jstjst/stmbl/hw/kicad/v5.0/stmbl_5.0.kicad_pcb

## KiCad design hw/kicad/v5.0/stmbl_5.0.kicad_pcb (2025-01-07)

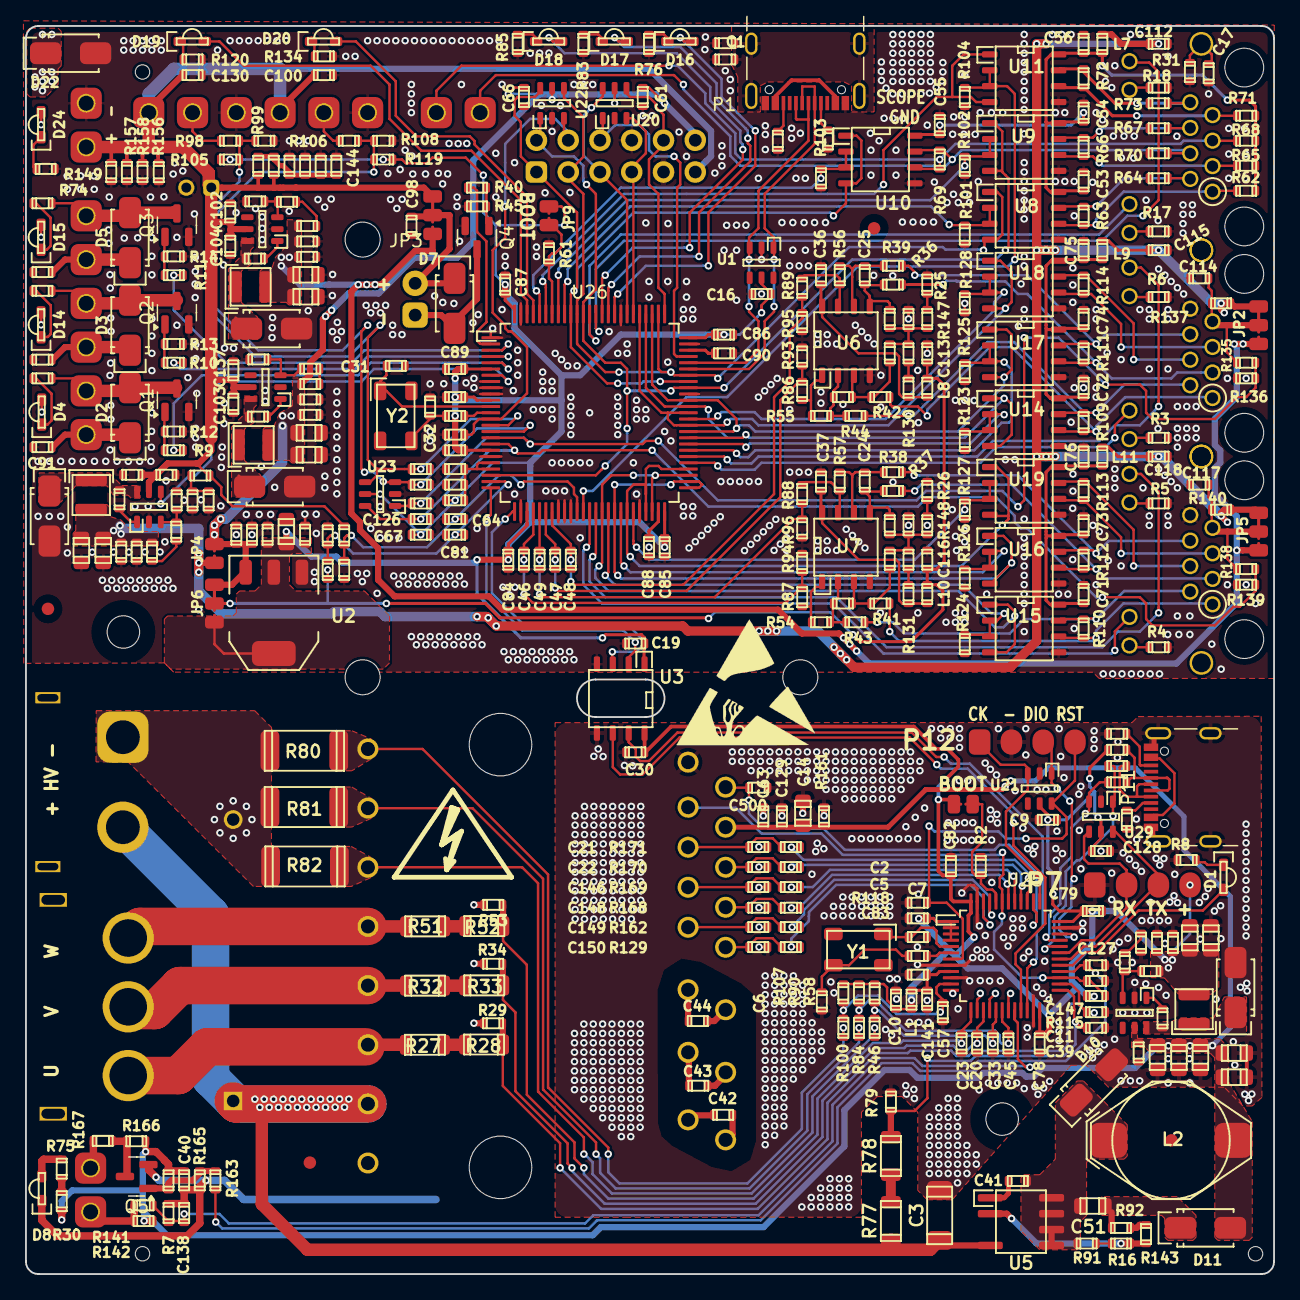
[picture p1: board stmbl_5.0.kicad_pcb from above]

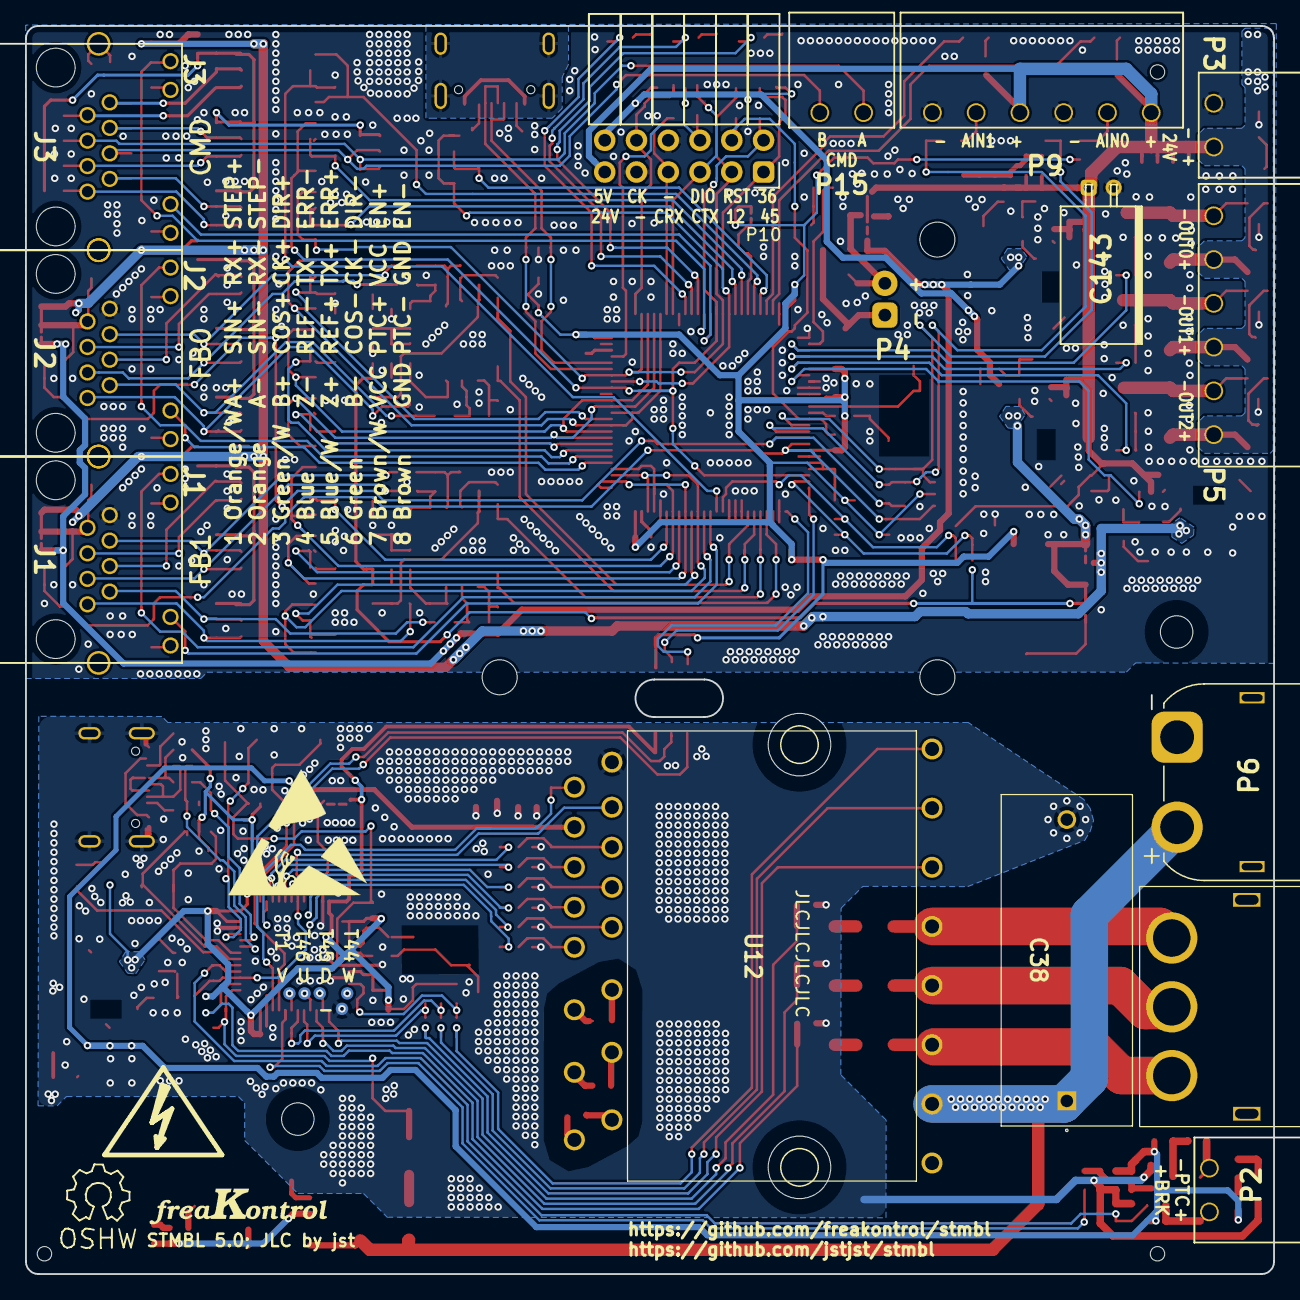
[picture p2: board stmbl_5.0.kicad_pcb from below]

Board: 2 copper layers, 99.8 x 99.8 mm, 425 parts (23 on the bottom side), 243 nets.

Parts:
C1, C2, C7, C9, C10, C12, C13, C15, C16, C17, C19, C29, C30, C36, C37, C40, C41, C53, C54, C55, C56, C58, C60, C61, C63, C66, C67, C71, C72, C73, C74, C75, C76, C77, C78, C79, C80, C82, C83, C84, C85, C86, C87, C89, C91, C94, C95, C96, C98, C99, C100, C103, C104, C105, C106, C107, C108, C112, C113, C114, C115, C116, C117, C118, C119, C120, C121, C122, C125, C126, C127, C128, C130, C138: 100n; C_0603
C3: 150n; C_1808
C4, C14, C35, C51, C68, C69, C70, C97, C109, C110, C111, C123, C124, C131, C132, C145: 10µ; C_0805
C5, C6, C11, C20, C23, C24, C25, C26, C27, C31, C32, C33, C39, C45, C57: 18p; C_0603
C8, C18, C42, C43, C44, C50, C62, C65, C88, C90, C101, C102, C129, C133, C134, C135, C136, C137, C139, C140, C141, C142, C144: 2.2µ; C_0603
C21, C22, C46, C47, C48, C49, C52, C59, C64, C81, C146, C147, C148, C149, C150, C500: 1n; C_0603
C38: 680n; potential_snubber01
C143: 22µ; C_Radial_D6.5_L11_P2.5
D1, D16: red; LED-0805-SIDE
D2, D3, D5, D7, D10, D11: ES1J R2; SMA_Standard
D4, D8, D14, D15, D18, D19, D20, D24: green; LED-0805-SIDE
D6, D9, D12, D13: SS34A; SMA_Standard
D17: yellow; LED-0805-SIDE
D22: SMAJ24A TVS 24V; SMA_Standard
J1, J2, J3: RJ45_LED
JP1, JP4, JP9: Jumper_NO_Small; SOLDER_JUMPER
JP2, JP3, JP5, JP6: JUMPER3_NC; SOLDER_JUMPER_3_NC
L1, L3, L7, L8, L9, L10, L11: 220r 700mA; R_0603
L2: 1m 250mA; NPI31W
L4: 4.7µH; SMD_INDUCTOR_32x25
L5, L12: 6.8µH; SMD_INDUCTOR_32x25
L6: 10µH 1A; SMD_INDUCTOR_32x25
LOGO1: OPEN_HARDWARE_1; Symbol_OSHW-Logo_SilkScreen
LOGO2: LOGO; Logo_Freakontrol_1
P1, P11: USB_C_Receptacle_USB2.0; USB_C_Receptacle_GCT_USB4105-xx-A_16P_TopMnt_Horizontal
P2, P3, P15: CONN_01X02; RM3.5_1x2
P4: CONN_01X02; Pin_Header_Angled_1x02
P5, P9: CONN_01X06; RM3.5_1x6
P6: CONN_01X02; AMASS_XT60IPW-M_1x03_P7.20mm_Horizontal
P7, P12: CONN_01X04; Pin_Header_Straight_1x04_smd
P8: CONN_01X03; AMASS Connector MT60_1
P10: CONN_02X06; Socket_Strip_Angled_2x06
Q1, Q2, Q3, Q4, Q5: IRLML6344; SOT-23
R1, R23, R24, R25, R26, R31, R109, R110, R111, R112, R113, R114, R130, R131: 120; R_0603
R2, R12, R13, R14, R15, R16, R30, R45, R61, R63, R66, R69, R72, R75, R91, R99, R101, R102, R103, R104, R105, R108, R117, R118, R119, R121, R122, R123, R124, R125, R126, R127, R128, R136, R139, R153, R165: 1k; R_0603
R3, R4, R5, R6, R8, R17, R18, R46, R76, R83, R84, R85, R93, R94, R95, R96, R100, R120, R134: 470; R_0603
R7, R35, R36, R37, R38, R39, R41, R42, R43, R44, R62, R64, R65, R67, R68, R70, R71, R73, R98, R106, R116, R132, R135, R137, R138, R140, R142, R155, R156, R157, R158: 10k; R_0603
R9, R10, R11, R40, R86, R87, R88, R89, R147, R148, R154, R159, R160, R163, R167, R175, R176: 22; R_0603
R19, R47, R48, R49, R50, R54, R55, R56, R57, R58, R90, R92, R107: 15k; R_0603
R20, R22, R29, R34, R53, R59, R74, R79, R115, R149, R161, R164, R166: 3.9k; R_0603
R21, R60, R97, R133, R141: 51k; R_0603
R27, R28, R32, R33, R51, R52, R77, R78: 249k; R_1206
R80, R81, R82: 0.002; R_2512
R129, R162, R168, R169, R170, R171: 100; R_0603
R143, R145, R174: 1.5k; R_0603
R144, R146, R152, R172, R173, R177: 5.1k; R_0603
REF1, REF3, REF4: Fiducial_1mm_Dia_2.54mm_Outer_CopperTop; Fiducial_1mm_Outer_CopperTop
T1, T2, T44, T45, T46: testpoint; Measurement_Point_Round-SMD-Pad_Small
U1, U20, U21, U22, U23, U29: USBLC6-4SC6; SOT-23-6
U2: zldo1117; SOT-223
U3: SI8621; SOIC-8-N
U4, U13, U24, U28: RT8259; SOT-23-6
U5: LNK304D; SOIC-7
U6, U7: LM358; SOIC-8-N
U8, U9, U10, U11, U14, U15, U16, U17, U18, U19: SN65176B; SOIC-8-N
U12: IKCM30F60GAXKMA1; IKCM30F60GAXKMA1_2
U25: STM32F303CBTx; LQFP-48_7x7mm_Pitch0.5mm
U26: STM32F405VG; LQFP-100_14x14mm_Pitch0.5mm
U234: fan; radial fan
Y1, Y2: 8M; Crystal_SMD_0503_4Pads

Connections:
+3.3VP: C2.1, C4.1, C9.1, C10.2, C30.2, C35.1, C50.1, C60.1, C78.2, C79.2, C82.2, C128.1, JP1.1, L1.2, L4.2, P7.4, R21.1, R58.2, R90.2, R107.2, R115.1, R174.2, U3.8 (VDD2), U21.5 (VBUS), U25.1 (VBAT), U25.2 (PC13), U25.3 (PC14), U25.4 (PC15), U25.24 (VDD), U25.36 (VDD), U25.48 (VDD), U29.5 (VBUS)
+3V3: C16.2, C18.1, C19.1, C67.1, C77.2, C80.2, C84.2, C85.2, C86.2, C87.2, C89.2, C99.1, C131.1, JP6.3, JP9.1, L3.2, R105.1, R119.1, U1.5 (VBUS), U2.2 (VO), U3.1 (VDD1), U23.5 (VBUS), U26.6 (VBAT), U26.11 (VDD), U26.19 (VDD), U26.28 (VDD), U26.50 (VDD), U26.75 (VDD), U26.100 (VDD)
+5F: C112.1, C115.2, C118.2, C122.1, C123.1, C124.1, C134.1, JP2.1, JP4.1, JP5.1, L7.2, L9.1, L11.1, L12.2, R137.2, R140.2, R144.1
+5V: C8.1, C61.1, C66.1, C96.1, C107.1, C109.1, C111.1, C135.1, JP4.2, JP6.1, L5.2, P10.12, R145.1, U2.3 (VI), U20.5 (VBUS), U22.5 (VBUS)
+5VA: C113.2, C116.2, JP6.2, L8.1, L10.1, R121.1
+12V: C108.1, C110.1, C132.1, C136.1, JP2.3, JP3.3, JP5.3, L6.2, R146.1
+15V: C14.2, C40.2, C58.1, C63.1, C68.1, C69.1, C70.1, C97.1, C129.1, C145.1, D11.2 (A), L2.2, R30.1, R142.1, R161.1, R164.1, R166.1, U4.5 (VIN), U12.13 (VDD)
+24V: C91.1, C94.1, C95.1, C100.1, C102.1, C103.1, C104.1, C120.1, C130.1, C133.1, C137.1, C143.1, D2.1 (K), D3.1 (K), D4.2 (A), D5.1 (K), D14.2 (A), D15.2 (A), D22.1 (K), D24.2 (A), JP3.1, P3.1, P5.1, P5.3, P5.5, P9.1, P9.4, P10.11, R116.1, R154.1, R155.1, R156.1, R157.1, R158.1, R159.1, R160.1, U13.5 (VIN), U24.5 (VIN), U28.5 (VIN)
/ctrl/CMD/D12: P10.3, U8.1 (RO), U8.4 (DI), U22.4 (I/O3), U26.69 (PA10/USART1_RX/TIM1_CH3/OTG_FS_ID/EVENT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), U26.77 (PA15/JTDI/SPI3_NSS/I2S3_WS/TIM2_CH1_ETR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), U26.90 (PB4/NJTRST/SPI3_MISO/TIM3_CH1/SPI1_MISO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)
/ctrl/CMD/D36: P10.2, U9.1 (RO), U9.4 (DI), U22.1 (I/O1), U26.23 (PA0/WKUP/USART2_CTS/UART4_TX/TIM2_CH1_E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), U26.67 (PA8/MCO1/USART1_CK/TIM1_CH1/I2C3_SCL/OT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), U26.89 (PB3/JTDO/TRACESWO/SPI3_SCK/I2S3_CK/TIM2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)
/ctrl/CMD/D45: P10.1, U10.1 (RO), U10.4 (DI), U22.6 (I/O4), U26.68 (PA9/USART1_TX/TIM1_CH2/I2C3_SMBA/EVENTO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), U26.91 (PB5/I2C1_SMBA/CAN2_RX/OTG_HS_ULPI_D7/TI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)
/ctrl/CMD/D78: U11.1 (RO), U11.4 (DI), U26.95 (PB8/TIM4_CH3/SDIO_D4/TIM10_CH1/I2C1_SCL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)
/ctrl/CMD/E12: R101.1, U8.2 (~RE), U8.3 (DE), U26.92 (PB6/I2C1_SCL/TIM4_CH1/CAN2_TX/USART1_TX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)
/ctrl/CMD/E36: R102.1, U9.2 (~RE), U9.3 (DE), U26.93 (PB7/I2C1_SDA/FSMC_NL/USART1_RX/TIM4_CH2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)
/ctrl/CMD/E45: R103.1, U10.2 (~RE), U10.3 (DE), U26.96 (PB9/SPI2_NSS/I2S2_WS/TIM4_CH4/TIM11_CH1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)
/ctrl/CMD/E78: R104.1, U11.2 (~RE), U11.3 (DE), U26.37 (PB2/BOOT1/EVENTOUT)
/ctrl/CMD/L1: J3.12, U26.88 (PD7/USART2_CK/FSMC_NE1/FSMC_NCE2/EVENTO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)
/ctrl/CMD/L2: J3.10, U26.87 (PD6/FSMC_NWAIT/USART2_RX/EVENTOUT)
/ctrl/FB0/A12: C47.1, R86.1, R93.1, U26.31 (PA6/SPI1_MISO/TIM8_BKIN/TIM13_CH1/TIM3_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)
/ctrl/FB0/A35: C48.1, R89.1, R95.1, U26.32 (PA7/SPI1_MOSI/TIM8_CH1N/TIM14_CH1/TIM3_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)
/ctrl/FB0/A78: C125.1, R135.2, R136.1, U23.1 (I/O1), U26.17 (PC2/SPI2_MISO/OTG_HS_ULPI_DIR/I2S2ext_S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)
/ctrl/FB0/D12: U14.1 (RO), U14.4 (DI), U26.59 (PD12/FSMC_ALE/FSMC_A17/TIM4_CH1/USART3_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), U26.64 (PC7/I2S3_MCK/TIM8_CH2/SDIO_D7/USART6_RX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), U26.79 (PC11/UART4_RX/SPI3_MISO/SDIO_D3/USART3_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)
/ctrl/FB0/D36: U17.1 (RO), U17.4 (DI), U26.60 (PD13/FSMC_A18/TIM4_CH2/EVENTOUT), U26.65 (PC8/TIM8_CH3/SDIO_D0/TIM3_CH3/USART6_CK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), U26.78 (PC10/SPI3_SCK/I2S3_CK/UART4_TX/SDIO_D2/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)
/ctrl/FB0/D45: U18.1 (RO), U18.4 (DI), U26.61 (PD14/FSMC_D0/TIM4_CH3/EVENTOUT/_EVENTOUT), U26.63 (PC6/I2S2_MCK/TIM8_CH1/SDIO_D6/USART6_TX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), U26.80 (PC12/UART5_TX/SDIO_CK/SPI3_MOSI/I2S3_SD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)
/ctrl/FB0/E12: R123.1, U14.2 (~RE), U14.3 (DE), U26.58 (PD11/FSMC_CLE/FSMC_A16/USART3_CTS/EVENT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)
/ctrl/FB0/E36: R125.1, U17.2 (~RE), U17.3 (DE), U26.57 (PD10/FSMC_D15/USART3_CK/EVENTOUT)
/ctrl/FB0/E45: R128.1, U18.2 (~RE), U18.3 (DE), U26.62 (PD15/FSMC_D1/TIM4_CH4/EVENTOUT)
/ctrl/FB0/L1: J2.12, U26.55 (PD8/FSMC_D13/USART3_TX/EVENTOUT)
/ctrl/FB0/L2: J2.10, U26.56 (PD9/FSMC_D14/USART3_RX/EVENTOUT)
/ctrl/FB1/A12: C46.1, R87.1, R94.1, U26.29 (PA4/SPI1_NSS/SPI3_NSS/USART2_CK/OTG_HS_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)
/ctrl/FB1/A35: C49.1, R88.1, R96.1, U26.30 (PA5/SPI1_SCK/OTG_HS_ULPI_CK/TIM2_CH1_ET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)
/ctrl/FB1/A78: C126.1, R138.2, R139.1, U23.6 (I/O4), U26.18 (PC3/SPI2_MOSI/I2S2_SD/OTG_HS_ULPI_NXT/E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)
/ctrl/FB1/D12: U15.1 (RO), U15.4 (DI), U26.40 (PE9/FSMC_D6/TIM1_CH1/EVENTOUT), U26.48 (PB11/I2C2_SDA/USART3_RX/OTG_HS_ULPI_D4/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), U26.53 (PB14/SPI2_MISO/TIM1_CH2N/TIM12_CH1/OTG_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)
/ctrl/FB1/D36: U16.1 (RO), U16.4 (DI), U26.42 (PE11/FSMC_D8/TIM1_CH2/EVENTOUT), U26.51 (PB12/SPI2_NSS/I2S2_WS/I2C2_SMBA/USART3_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), U26.52 (PB13/SPI2_SCK/I2S2_CK/USART3_CTS/TIM1_C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)
/ctrl/FB1/D45: U19.1 (RO), U19.4 (DI), U26.44 (PE13/FSMC_D10/TIM1_CH3/EVENTOUT), U26.47 (PB10/SPI2_SCK/I2S2_CK/I2C2_SCL/USART3_T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), U26.54 (PB15/SPI2_MOSI/I2S2_SD/TIM1_CH3N/TIM8_C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)
/ctrl/FB1/E12: R124.1, U15.2 (~RE), U15.3 (DE), U26.41 (PE10/FSMC_D7/TIM1_CH2N/EVENTOUT)
/ctrl/FB1/E36: R126.1, U16.2 (~RE), U16.3 (DE), U26.43 (PE12/FSMC_D9/TIM1_CH3N/EVENTOUT)
/ctrl/FB1/E45: R127.1, U19.2 (~RE), U19.3 (DE), U26.45 (PE14/FSMC_D11/TIM1_CH4/EVENTOUT)
/ctrl/FB1/L1: J1.12, U26.38 (PE7/FSMC_D4/TIM1_ETR/EVENTOUT)
/ctrl/FB1/L2: J1.10, U26.39 (PE8/FSMC_D5/TIM1_CH1N/EVENTOUT)
/ctrl/IO/CAN_RX: P10.7, U20.3 (I/O2), U26.81 (PD0/FSMC_D2/CAN1_RX/EVENTOUT)
/ctrl/IO/CAN_TX: P10.5, U20.6 (I/O4), U26.82 (PD1/FSMC_D3/CAN1_TX/EVENTOUT)
/ctrl/IO/IO_FAN: R40.2, U26.2 (PE3/TRACED0/FSMC_A19/EVENTOUT)
/ctrl/IO/IO_GREEN: D18.2 (A), U26.86 (PD5/FSMC_NWE/USART2_TX/EVENTOUT)
/ctrl/IO/IO_IN0: C52.1, R98.2, R99.1, R105.2, U23.4 (I/O3), U26.15 (PC0/OTG_HS_ULPI_STP/EVENTOUT)
/ctrl/IO/IO_IN1: C59.1, R106.2, R108.1, R119.2, U23.3 (I/O2), U26.16 (PC1/_EVENTOUT)
/ctrl/IO/IO_L0: D19.2 (A), U26.98 (PE1/FSMC_NBL1/EVENTOUT)
/ctrl/IO/IO_L1: D20.2 (A), U26.97 (PE0/TIM4_ETR/FSMC_NBL0/EVENTOUT)
/ctrl/IO/IO_OUT0: R11.2, U26.3 (PE4/TRACED1/FSMC_A20/EVENTOUT)
/ctrl/IO/IO_OUT1: R10.2, U26.4 (PE5/TRACED2/FSMC_A21/TIM9_CH1/EVENTOUT)
/ctrl/IO/IO_OUT2: R9.2, U26.5 (PE6/TRACED3_/_FSMC_A22/TIM9_CH2/EVENTOUT)
/ctrl/IO/IO_RED: D16.2 (A), U26.84 (PD3/FSMC_CLK/USART2_CTS/EVENTOUT)
/ctrl/IO/IO_YELLOW: D17.2 (A), U26.85 (PD4/FSMC_NOE/USART2_RTS/EVENTOUT)
/ctrl/IO/NRST: C29.2, P10.4, U22.3 (I/O2), U26.14 (NRST)
/ctrl/IO/SWCK: P10.10, U20.4 (I/O3), U26.76 (PA14/JTCK/SWCLK/EVENTOUT)
/ctrl/IO/SWDIO: P10.6, U20.1 (I/O1), U26.72 (PA13/JTMS/SWDIO/EVENTOUT)
/ctrl/RX: U3.3 (A2), U26.26 (PA3/USART2_RX/TIM5_CH4/TIM9_CH2/TIM2_CH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)
/ctrl/TX: U3.2 (A1), U26.25 (PA2/USART2_TX/TIM5_CH3/TIM9_CH1/TIM2_CH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)
/ctrl/f4/A_5V: C81.1, R121.2, R122.1, U26.24 (PA1/USART2_RTS/UART4_RX/TIM5_CH2/TIMM2_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)
/ctrl/f4/A_24V: C64.1, R116.2, R117.1, U26.36 (PB1/TIM3_CH4/TIM8_CH3N/OTG_HS_ULPI_D2/O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)
/ctrl/f4/EN_5V: U26.7 (PC13/EVENTOUT), U28.4 (EN)
/ctrl/f4/shield: C1.1, P1.S1 (SHIELD), R1.1
/hv/back-emf/HV_: C39.1, R78.2, R79.1, U25.25 (PB12)
/hv/back-emf/U: P8.3, R27.1, U12.22 (U)
/hv/back-emf/U_: C11.1, R28.2, R29.1, U25.26 (PB13)
/hv/back-emf/V: P8.2, R32.1, U12.21 (V)
/hv/back-emf/V_: C20.1, R33.2, R34.1, U25.15 (PA5)
/hv/back-emf/W: P8.1, R51.1, U12.20 (W)
/hv/back-emf/W_: C23.1, R52.2, R53.1, U25.13 (PA3)
/hv/cur/A_IU: C33.1, R46.1, R58.1, U25.17 (PA7)
/hv/cur/A_IV: C45.1, R84.1, R90.1, U25.18 (PB0)
/hv/cur/A_IW: C57.1, R100.1, R107.1, U25.11 (PA1)
/hv/cur/IU: R46.2, R82.1, U12.19 (NU)
/hv/cur/IV: R81.1, R84.2, U12.18 (NV)
/hv/cur/IW: R80.1, R100.2, U12.17 (NW)
/hv/driver/HU: R129.1, U25.46 (PB9)
/hv/driver/HV: R162.1, U25.45 (PB8)
/hv/driver/HW: R168.1, U25.42 (PB6)
/hv/driver/LU: R169.1, U25.41 (PB5)
/hv/driver/LV: R170.1, U25.40 (PB4)
/hv/driver/LW: R171.1, U25.39 (PB3)
/hv/driver/Vth: C147.1, R115.2, U12.14 (VFO), U25.27 (PB14), U25.43 (PB7)
/hv/driver/itrip: C500.1, U12.15 (ITRIP), U25.38 (PA15)
/hv/f3/A_T_MOT: C127.2, C138.2, R7.2, R141.2, U25.28 (PB15)
/hv/f3/BRK: R163.1, U25.20 (PB2)
/hv/f3/HV_RX: U3.7 (B1), U25.22 (PB11)
/hv/f3/HV_TX: U3.6 (B2), U25.21 (PB10)
/hv/f3/IO_RX: P7.2, U25.31 (PA10), U29.4 (I/O3)
/hv/f3/IO_TX: P7.3, U25.30 (PA9), U29.6 (I/O4)
/hv/f3/NRST: C7.1, P12.4, U21.6 (I/O4), U25.7 (NRST)
/hv/f3/SWCLK: P12.1, U21.3 (I/O2), U25.37 (PA14)
/hv/f3/SWDIO: P12.3, U21.1 (I/O1), U25.34 (PA13)
/hv/f3/USB_DM: R175.1, U25.32 (PA11), U29.1 (I/O1)
/hv/f3/USB_DP: R176.1, U25.33 (PA12), U29.3 (I/O2)
GND: C1.2, C8.2, C12.2, C13.2, C16.1, C17.2, C18.2, C19.2, C29.1, C31.2, C32.2, C36.1, C37.1, C46.2, C47.2, C48.2, C49.2, C52.2, C53.2, C54.2, C55.2, C56.2, C59.2, C61.2, C62.2, C64.2, C65.1, C66.2, C67.2, C71.2, C72.2, C73.2, C74.2, C75.2, C76.2, C77.1, C80.1, C81.2, C84.1, C85.1, C86.1, C87.1, C88.2, C89.1, C90.2, C91.2, C94.2, C95.2, C96.2, C98.2, C99.2, C100.2, C101.2, C102.2, C103.2, C104.2, C107.2, C108.2, C109.2, C110.2, C111.2, C112.2, C113.1, C114.2, C115.1, C116.1, C117.2, C118.1, C119.1, C120.2, C122.2, C123.2, C124.2, C125.2, C126.2, C130.2, C131.2, C132.2, C133.2, C134.2, C135.2, C136.2, C137.2, C139.2, C140.2, C142.2, C143.2, C144.2, D9.2 (A), D12.2 (A), D13.2 (A), D22.2 (A), J1.8, J2.8, P1.A1 (GND), P1.A12 (GND), P1.B1 (GND), P1.B12 (GND), P3.2, P9.3, P9.6, P10.8, P10.9, Q1.2 (S), Q2.2 (S), Q3.2 (S), Q4.2 (S), R1.2, R3.2, R4.2, R5.2, R6.2, R12.2, R13.2, R14.2, R17.2, R18.2, R25.2, R26.2, R31.2, R35.2, R45.2, R59.2, R61.1, R64.2, R67.2, R70.2, R73.2, R76.2, R83.2, R85.2, R93.2, R94.2, R95.2, R96.2, R99.2, R101.2, R102.2, R103.2, R104.2, R108.2, R117.2, R120.2, R122.2, R123.2, R124.2, R125.2, R126.2, R127.2, R128.2, R132.2, R134.2, R136.2, R139.2, R149.2, R152.1, R155.2, R156.2, R157.2, R158.2, R177.1, U1.2 (GND), U2.1 (GND), U3.4 (GND1), U6.4 (V-), U7.4 (V-), U8.5 (GND), U9.5 (GND), U10.5 (GND), U11.5 (GND), U13.2 (GND), U14.5 (GND), U15.5 (GND), U16.5 (GND), U17.5 (GND), U18.5 (GND), U19.5 (GND), U20.2 (GND), U22.2 (GND), U23.2 (GND), U24.2 (GND), U26.1 (PE2/TRACECLK/FSMC_A23/EVENTOUT), U26.8 (PC14/OSC32_IN/EVENTOUT), U26.9 (PC15/OSC32_OUT/EVENTOUT), U26.10 (VSS), U26.20 (VSSA), U26.27 (VSS), U26.33 (PC4/EVENTOUT), U26.34 (PC5/EVENTOUT), U26.35 (PB0/TIM3_CH3/TIM8_CH2N/OTG_HS_ULPI_D1/T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), U26.46 (PE15/FSMC_D12/TIM1_BKIN/EVENTOUT), U26.66 (PC9/I2S_CKIN/MCO2/TIM8_CH4/SDIO_D1/I2C3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), U26.74 (VSS), U26.83 (PD2/TIM3_ETR/UART5_RX/SDIO_CMD/EVENTOUT), U26.99 (VSS), U28.2 (GND)
GNDD: C17.1, J1.13, J2.13, J3.13, R31.1
GNDPWR: C2.2, C3.2, C4.2, C5.2, C6.2, C7.2, C9.2, C10.1, C11.2, C14.1, C20.2, C21.2, C22.2, C23.2, C30.1, C33.2, C35.2, C38.2, C39.2, C40.1, C45.2, C50.2, C57.2, C58.2, C60.2, C63.2, C68.2, C69.2, C70.2, C78.1, C79.1, C82.1, C83.1, C97.2, C127.1, C128.2, C129.2, C138.1, C141.1, C145.2, C146.2, C147.2, C148.2, C149.2, C150.2, C500.2, D6.2 (A), D8.1 (K), D10.2 (A), P6.1, P7.1, P11.A1 (GND), P11.A12 (GND), P11.B1 (GND), P11.B12 (GND), P11.S1 (SHIELD), P12.2, Q5.2 (S), R2.2, R7.1, R8.1, R15.2, R29.2, R34.2, R53.2, R79.2, R80.2, R81.2, R82.2, R161.2, R165.2, R172.1, R173.1, T2.1, U3.5 (GND2), U4.2 (GND), U12.16 (VSS), U21.2 (GND), U25.8 (VSSA), U25.10 (PA0), U25.23 (VSS), U25.35 (VSS), U25.47 (VSS), U29.2 (GND)
unnamed: C6.1, R118.2, Y1.2
unnamed: C12.1, R23.2, R48.1, R49.1, R148.1
unnamed: C13.1, R24.2, R47.1, R50.1, R147.1
unnamed: C32.1, R153.2, Y2.2
unnamed: C62.1, C101.1, R159.2
unnamed: C114.1, J2.7, JP2.2, R135.1, R137.1
unnamed: C117.1, J1.7, JP5.2, R138.1, R140.1
unnamed: C139.1, C140.1, C142.1, C144.1, R154.2, R160.2
unnamed: D1.2 (A), U25.29 (PA8)
unnamed: D1.1 (K), R8.2
unnamed: D2.2 (A), P5.2, Q1.3 (D), R20.2
unnamed: D3.2 (A), P5.4, Q2.3 (D), R22.2
unnamed: D4.1 (K), R20.1
unnamed: D5.2 (A), P5.6, Q3.3 (D), R74.2
unnamed: C15.2, D6.1 (K), L4.1, U4.6 (PH)
unnamed: D7.2 (A), P4.1, Q4.3 (D)
unnamed: C98.1, D7.1 (K), JP3.2, P4.2
unnamed: D8.2 (A), R75.2
unnamed: C105.2, D9.1 (K), L5.1, U13.6 (PH)
unnamed: C41.2, C51.2, D10.1 (K), L2.1, R91.1, U5.5 (S), U5.6 (S), U5.7 (S), U5.8 (S)
unnamed: C51.1, D11.1 (K), R92.2
unnamed: C106.2, D12.1 (K), L6.1, U24.6 (PH)
unnamed: C121.2, D13.1 (K), L12.1, U28.6 (PH)
unnamed: D14.1 (K), R22.1
unnamed: D15.1 (K), R74.1
unnamed: D16.1 (K), R76.1
unnamed: D17.1 (K), R83.1
unnamed: D18.1 (K), R85.1
unnamed: D19.1 (K), R120.1
unnamed: D20.1 (K), R134.1
unnamed: D24.1 (K), R149.1
unnamed: J1.9, R5.1
unnamed: J1.11, R4.1
unnamed: J2.9, R6.1
unnamed: J2.11, R3.1
unnamed: J3.9, R18.1
unnamed: J3.11, R17.1
unnamed: P1.A5 (CC1), R152.2
unnamed: P1.B5 (CC2), R177.2
unnamed: P1.A4 (VBUS), P1.A9 (VBUS), P1.B4 (VBUS), P1.B9 (VBUS)
unnamed: P2.1, R141.1, R142.2
unnamed: P2.2, R167.2
unnamed: P9.2, R98.1
unnamed: P9.5, R106.1
unnamed: P11.A5 (CC1), R172.2
unnamed: P11.B5 (CC2), R173.2
unnamed: P11.A6 (D+), P11.B6 (D+), R174.1, R176.2
unnamed: P11.A7 (D-), P11.B7 (D-), R175.2
unnamed: P11.A4 (VBUS), P11.A9 (VBUS), P11.B4 (VBUS), P11.B9 (VBUS)
unnamed: J3.5, P15.1, R68.2, R69.1, U10.6 (A)
unnamed: J3.4, P15.2, R69.2, R70.1, U10.7 (B)
unnamed: Q1.1 (G), R9.1, R12.1
unnamed: Q2.1 (G), R10.1, R13.1
unnamed: Q3.1 (G), R11.1, R14.1
unnamed: Q4.1 (G), R40.1, R45.1
unnamed: Q5.3 (D), R166.2, R167.1
unnamed: Q5.1 (G), R163.2, R164.2, R165.1
unnamed: R15.1, R19.2
unnamed: R16.1, R91.2
unnamed: R27.2, R28.1
unnamed: R30.2, R75.1
unnamed: R32.2, R33.1
unnamed: R51.2, R52.1
unnamed: R54.1, R87.2, U7.1
unnamed: R55.1, R86.2, U6.1
unnamed: R56.1, R89.2, U6.7
unnamed: R57.1, R88.2, U7.7
unnamed: R77.2, R78.1
unnamed: R24.1, R130.2
unnamed: R23.1, R131.2
unnamed: R133.1, R144.2
unnamed: R92.1, R143.2
unnamed: R60.1, R145.2
unnamed: R97.1, R146.2
unnamed: R25.1, R147.2
unnamed: R26.1, R148.2
unnamed: P1.A7 (D-), P1.B7 (D-), U1.1 (I/O1), U26.70 (PA11/USART1_CTS/CAN1_RX/TIM1_CH4_/OTG_F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)
unnamed: P1.A6 (D+), P1.B6 (D+), U1.3 (I/O2), U26.71 (PA12/USART1_RTS/CAN1_TX/TIM1_ETR/OTG_FS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)
unnamed: C15.1, U4.1 (BST)
unnamed: R19.1, R21.2, U4.3 (FB)
unnamed: C41.1, U5.1 (BP)
unnamed: R16.2, R143.1, U5.2 (FB)
unnamed: C27.1, R42.1, R47.2, U6.3 (+)
unnamed: C27.2, R44.1, R55.2, U6.2 (-)
unnamed: C25.1, R36.1, R50.2, U6.5 (+)
unnamed: C25.2, R39.1, R56.2, U6.6 (-)
unnamed: C36.2, L8.2, R130.1, U6.8 (V+)
unnamed: C26.1, R41.1, R48.2, U7.3 (+)
unnamed: C26.2, R43.1, R54.2, U7.2 (-)
unnamed: C24.1, R37.1, R49.2, U7.5 (+)
unnamed: C24.2, R38.1, R57.2, U7.6 (-)
unnamed: C37.2, L10.2, R131.1, U7.8 (V+)
unnamed: J3.1, R62.2, R63.1, U8.6 (A)
unnamed: J3.2, R63.2, R64.1, U8.7 (B)
unnamed: J3.3, R65.2, R66.1, U9.6 (A)
unnamed: J3.6, R66.2, R67.1, U9.7 (B)
unnamed: C53.1, C54.1, C55.1, C56.1, L7.1, R62.1, R65.1, R68.1, R71.1, U8.8 (VCC), U9.8 (VCC), U10.8 (VCC), U11.8 (VCC)
unnamed: J3.7, R71.2, R72.1, U11.6 (A)
unnamed: J3.8, R72.2, R73.1, U11.7 (B)
unnamed: C150.1, R129.2, U12.7 (HIN(U))
unnamed: C149.1, R162.2, U12.8 (HIN(V))
unnamed: C148.1, R168.2, U12.9 (HIN(W))
unnamed: C146.1, R169.2, U12.10 (LIN(U))
unnamed: C22.1, R170.2, U12.11 (LIN(V))
unnamed: C21.1, R171.2, U12.12 (LIN(W))
unnamed: C42.1, U12.2 (VB(U))
unnamed: C43.1, U12.4 (VB(V))
unnamed: C44.1, U12.6 (VB(W))
unnamed: C42.2, U12.1 (VS(U))
unnamed: C43.2, U12.3 (VS(V))
unnamed: C44.2, U12.5 (VS(W))
unnamed: C105.1, U13.1 (BST)
unnamed: R35.1, R60.2, U13.3 (FB)
unnamed: J2.1, R42.2, R109.1, U14.6 (A)
unnamed: J2.2, R44.2, R109.2, U14.7 (B)
unnamed: C72.1, C74.1, C75.1, L9.2, U14.8 (VCC), U17.8 (VCC), U18.8 (VCC)
unnamed: J1.1, R41.2, R110.1, U15.6 (A)
unnamed: J1.2, R43.2, R110.2, U15.7 (B)
unnamed: C71.1, C73.1, C76.1, L11.2, U15.8 (VCC), U16.8 (VCC), U19.8 (VCC)
unnamed: J1.3, R37.2, R112.1, U16.6 (A)
unnamed: J1.6, R38.2, R112.2, U16.7 (B)
unnamed: J2.3, R36.2, R111.1, U17.6 (A)
unnamed: J2.6, R39.2, R111.2, U17.7 (B)
unnamed: J2.5, R114.1, U18.6 (A)
unnamed: J2.4, R114.2, U18.7 (B)
unnamed: J1.5, R113.1, U19.6 (A)
unnamed: J1.4, R113.2, U19.7 (B)
unnamed: C106.1, U24.1 (BST)
unnamed: R59.1, R97.2, U24.3 (FB)
unnamed: JP1.2, R2.1, U25.44 (BOOT0)
unnamed: T44.1, U25.12 (PA2)
unnamed: T45.1, U25.14 (PA4)
unnamed: T46.1, U25.16 (PA6)
unnamed: T1.1, U25.19 (PB1)
unnamed: C5.1, U25.5 (PF0), Y1.1
unnamed: R118.1, U25.6 (PF1)
unnamed: C83.2, C141.2, L1.1, U25.9 (VDDA)
unnamed: JP9.2, R61.2, U26.94 (BOOT0)
unnamed: C31.1, U26.12 (PH0/OSC_IN/EVENTOUT), Y2.1
unnamed: R153.1, U26.13 (PH1/OSC_OUT/EVENTOUT)
unnamed: C88.1, U26.49 (VCAP_1)
unnamed: C90.1, U26.73 (VCAP_2)
unnamed: C65.2, C119.2, L3.1, U26.21 (VREF+), U26.22 (VDDA)
unnamed: C121.1, U28.1 (BST)
unnamed: R132.1, R133.2, U28.3 (FB)
VPP: C3.1, C38.1, P6.2, R77.1, U5.4 (D), U12.23
