jstjst/stmbl/(threads)

Thread 1 (2025-01-03):

PCB Layout

jstjst, 2025-01-03:
- [ ] Inductors are difficult to solder by hand
- [ ] C3 is difficult to solder by hand
- [ ] RJ45 holes for the plastic pins are to small

Thread 3 (2025-03-20):

Is this suport step/dir input??

artayasa, 2025-03-20:
Good day mate, stmbl V5 is suport step/dir input? Because i see only suport smartserial, and open can, but original stmbl are suport step/dir.

Also fot stm32f405vgt6 posoble to change to f407zgt6?? Because hard to find in my country. Thank u

artayasa, 2025-03-21:
> step/dir 5v input Will I run it is work in mach3 mach4 grbl . I am also curious about the answer to this question.

So u try already step/dir input stmbl v5?? Its work???

Overspeed666, 2025-03-21:
> > step/dir 5v girişi mach3 mach4 grbl de çalışır mı acaba. Bu sorunun cevabını bende merak ediyorum.
>
> Peki step/dir input stmbl v5'i denedin mi? Çalışıyor mu???

.

Overspeed666, 2025-03-21:
> > step/dir 5v girişi mach3 mach4 grbl de çalışır mı acaba. Bu sorunun cevabını bende merak ediyorum.
>
> Peki step/dir input stmbl v5'i denedin mi? Çalışıyor mu???

Something caught my attention. Your comments are available in every field I am interested in. Misan DC servo project.

artayasa, 2025-03-21:
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

Yess mate, because i have plenty ac servo drive without driver, and loking for foc pmsm suport step/dir, my knowlidge about coding are bad, but litle bit understand mate.

Overspeed666, 2025-03-21:
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

Don't waste time ,money
orjinal drive buy instead

artayasa, 2025-03-21:
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

No man i like DIY man, 😂😂 i have also 10 panasonic minas A5 with driver. For now still just looking on my free time, but long time i love stmbl, 😁😁
